MohamedElshishtawy/Line_Follwer_Car/Project photos & Videos/WhatsApp Image 2026-05-24 at 3.25.10 PM (1).jpeg

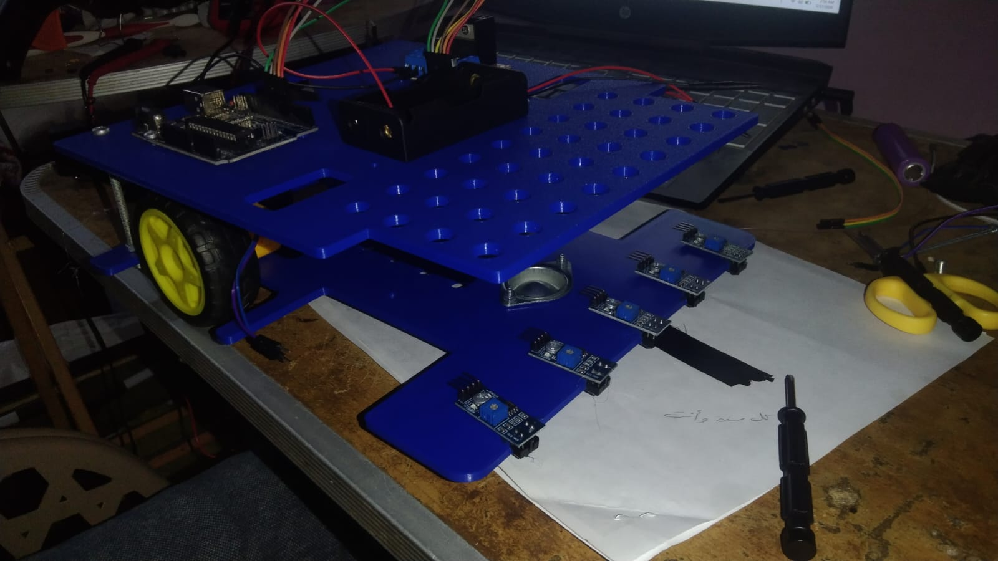
Project photos & Videos/WhatsApp Image 2026-05-24 at 3.25.10 PM (1).jpeg
