MohamedElshishtawy/Line_Follwer_Car/Structure/Bottom Part/the bottom chasiss part.SLDPRT

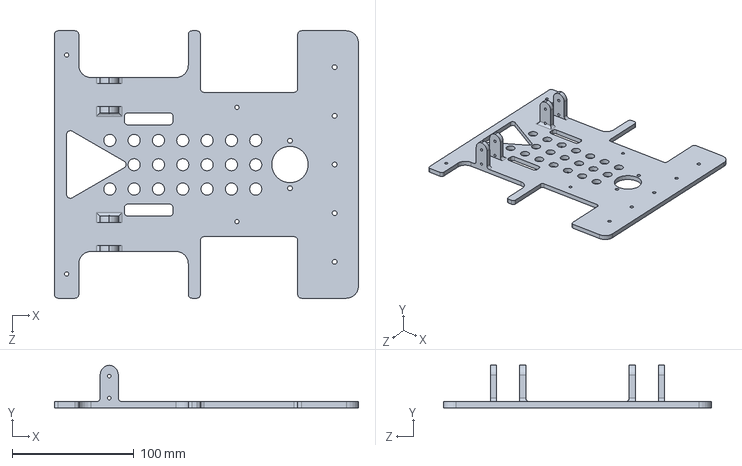
[picture p15: CAD file, 2026-05-17]
Structure/Bottom Part/the bottom chasiss part.SLDPRT
250.0 x 35.0 x 220.0 mm
