MohamedElshishtawy/Line_Follwer_Car/Structure/Top Part/The top chasiss part.SLDPRT

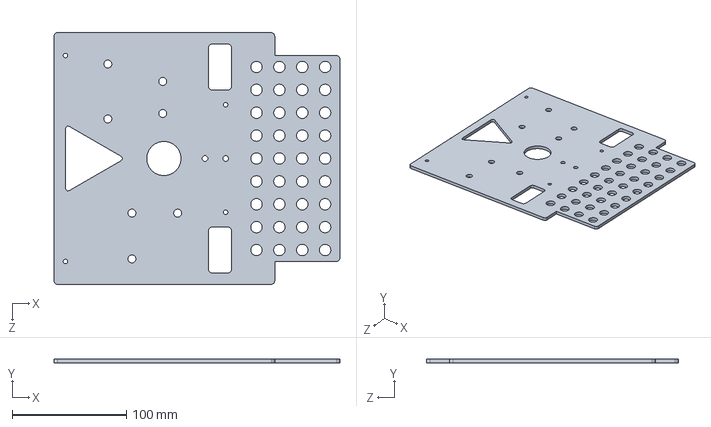
[picture p16: CAD file, 2026-05-17]
Structure/Top Part/The top chasiss part.SLDPRT
250.0 x 3.50 x 220.0 mm
