MohamedElshishtawy/Line_Follwer_Car/(list of files, cad)

Other CAD files:
Structure/Bottom Part/the bottom chasiss part.SLDDRW
Structure/Bottom Part/the bottom chasiss part.STL
Structure/Top Part/The top chasiss part.SLDDRW
Structure/Top Part/The top chasiss part.STL
