MohamedElshishtawy/Line_Follwer_Car/(commit log)

2026-05-13 Recfactor some dimetions for the top and bottom structure
    [The top chasiss part.SLDDRW, The top chasiss part.SLDPRT, the bottom chasiss part.SLDDRW, the bottom chasiss part.SLDPRT, the bottom chasiss part.STL]
2026-05-17 Add robot control script with UI and sensor handling
2026-05-17 Adding The main source code of the arduino and matlab
